DRWUKAS/Precision-Tweezer-Grinder/README.md

# Precision Tweezers Grinder — Hack Club Stasis

An enclosure and hardware design for a precision tweezers grinder built during the Hack Club Stasis hackathon. This device provides a stable, motorized solution for sharpening and maintaining precision tools.

🌐 **OnShape CAD Workspace:** https://cad.onshape.com/documents/27c54b4b3d9ffb5c67df1a65/w/bfb7f68973eb2576e4aceb32/e/55b7abdc1bfcae4972785b61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

---

## 🛠️ Hardware & Components
* **Motor:** 5V DC Motor
* **Switch:** SPDT Toggle Switch
* **Power Input:** Direct USB Cable (modified 5V input)
* **Fasteners:** M3 Screws (tapped holes)

## 📑 Engineering Build Logs & Journal

### 🛠️ Log 1: Sketching and Main Measurements/Design
* **Focus:** Initial Component Gathering & Concept Layout
* Gathered all core project components: a 5V DC motor, SPDT switch, and USB power components.
* Sketched out all physical dimensions of the components by hand to translate the physical sizes into clean CAD parameters within OnShape.
 


### 💻 Log 2: Day 1 CAD Base
* **Focus:** Main Body Enclosure and Press-Fits
* Designed the primary motor and switch models in OnShape to visualize the spacing constraints.
* Built out the main body chassis and recessed a fitted compartment for the motor core.
* Designed mounting tabs for the top and bottom chassis split using $2.4\text{ mm}$ diameter guide holes optimized for custom tapping to M3 threads.
* Integrated a precise, low-clearance press-fit slot to securely friction-mount the SPDT switch into the outer shell wall.





### 🖨️ Log 3: First Print & CAD Refinements
* **Focus:** Proof of Concept & Tolerance Adjustment
* **Time Tracked:** 2 hours (1 hr 15 mins CAD / 45 mins assembly and tinkering)
* Manufactured the initial 3-part prototype assembly via a 3D printer.
* **Discovered Design Issues:**
  * The vertical alignment column on the base plate sat too close to the main structural wall, preventing clean fabrication with a standard $0.4\text{ mm}$ extrusion nozzle.
  * The raw Micro-USB cutout area required removal in favor of a specialized alignment pad on the lower chassis plate to simplify printing and increase wall stiffness.
  * The internal motor seating pocket wall required wider clearance for a smooth drop-in fit.
    
    
    

### 🔧 Log 4: Final Adjustments & Part Fitment
* **Focus:** Hardware Integration & Mechanical Finish
* **Time Tracked:** 45 minutes (0.75 hours)
* Modified hole dimensions and re-worked the Micro-USB retention bracket constraints to lock it permanently in place against internal sliding forces.
* Fabricated the updated component set. All adjusted clearances matched physical parts perfectly.
* Tapped the main case guide holes for M3 hardware, routed all internal components, and securely bolted the entire enclosure shell together.
  
  
  

### ⚡ Log 5: Soldering & Final Assembly
* **Focus:** Wiring and Integration Challenges
* **Time Tracked:** 2 hours 20 minutes (2.33 hours)
* Hit unexpected integration friction while working with the standalone Micro-USB interface port. Soldering raw wires directly onto mini interface pins without creating solder bridges or wire detachment issues proved incredibly difficult.
* **Engineering Pivot:** Bypassed the unstable breakout interface port by stripping a standard USB power cable down to raw copper leads, routing it directly into the chassis, and soldering it inline.
* **Result:** Successfully closed the loop! The circuit operates reliably under full load. Future revisions will transition to a dedicated USB power breakout board for a cleaner commercial finish.
  
  

  #Video Of Working Project
  https://www.youtube.com/shorts/dYoDzPScT6I

  ## 📂 Project Repository Files

<details>
<summary>📦 <b>Click to expand individual CAD & 3D Print Files</b></summary>

### 🛠️ Master CAD Source Files (.step)
* 💾 [Assembly 1.step](./Assembly%201.step)
* 💾 [Bottom Half.step](./Bottom%20Half.step)
* 💾 [Motor.step](./Motor.step)
* 💾 [Precision tweezers Main Body.step](./Precision%20tweezers%20Main%20Body.step)
* 💾 [Switch.step](./Switch.step)
* 💾 [Top Spinner.step](./Top%20Spinner.step)
* 💾 [USB.step](./USB.step)

### 🖨️ 3D Printable Mesh Files (.stl)
* 🧩 [Assembly 1.stl](./Assembly%201.stl)
* 🧩 [Bottom Half (3).stl](./Bottom%20Half%20(3).stl)
* 🧩 [Motor.stl](./Motor.stl)
* 🧩 [Precision tweezers Main Body (2).stl](./Precision%20tweezers%20Main%20Body%20(2).stl)
* 🧩 [Switch.stl](./Switch.stl)
* 🧩 [Top Spinner (2).stl](./Top%20Spinner%20(2).stl)
* 🧩 [USB.stl](./USB.stl)
