DRWUKAS/Precision-Tweezer-Grinder/BOM.csv

BOM.csv
Item | Quantity | Description
5V DC Motor | 1 | Prime motor for the grinding mechanism
SPDT Rocker Switch | 1 | Power actuation toggle
USB Power Cable | 1 | Stripped copper wire connection for 5V input
M3 Machine Screws | 4 | Fasteners for holding chassis shell halves together
3D Printed PLA Enclosure | 1 | Custom chassis parts designed in Onshape
