DRWUKAS/Precision-Tweezer-Grinder/Assembly 1.step

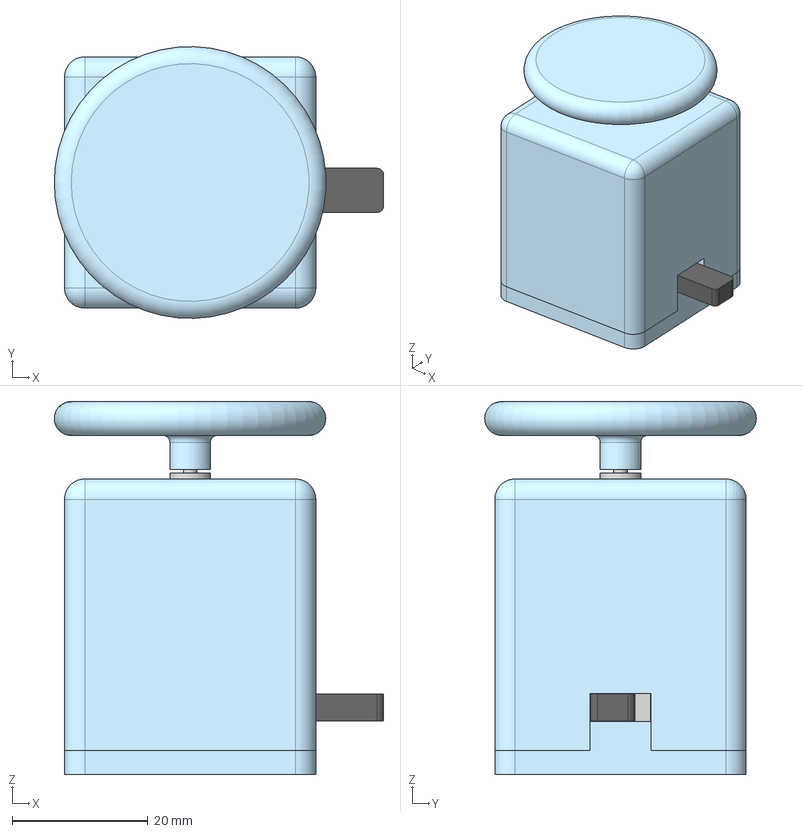
[picture p1: CAD file, 2026-06-20]
Assembly 1.step
48.5 x 40.0 x 54.9 mm
