DRWUKAS/Precision-Tweezer-Grinder/Precision tweezers Main Body.step

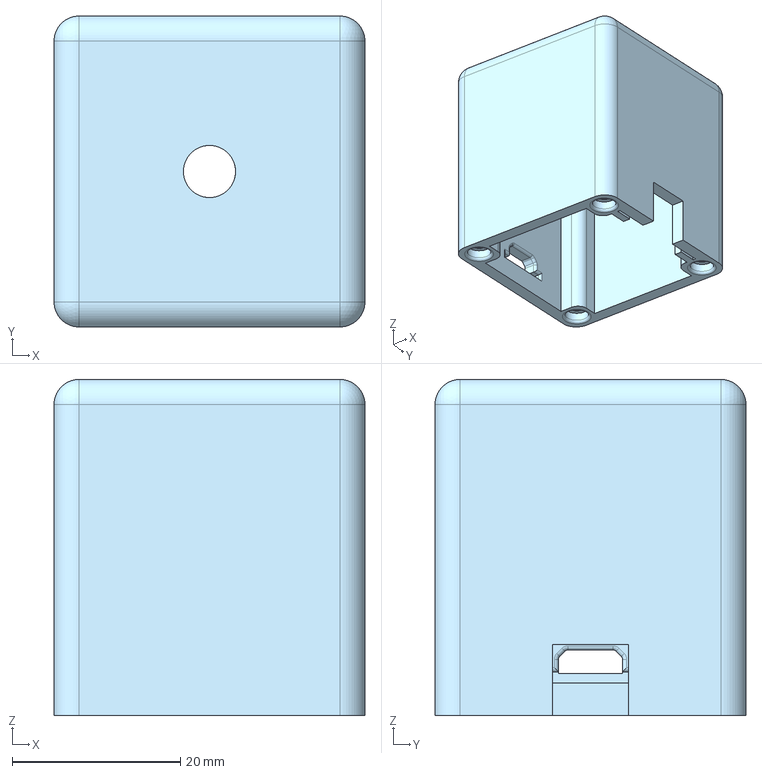
[picture p2: CAD file, 2026-06-20]
Precision tweezers Main Body.step
37.0 x 37.0 x 40.0 mm
