DRWUKAS/Precision-Tweezer-Grinder/Top Spinner.step

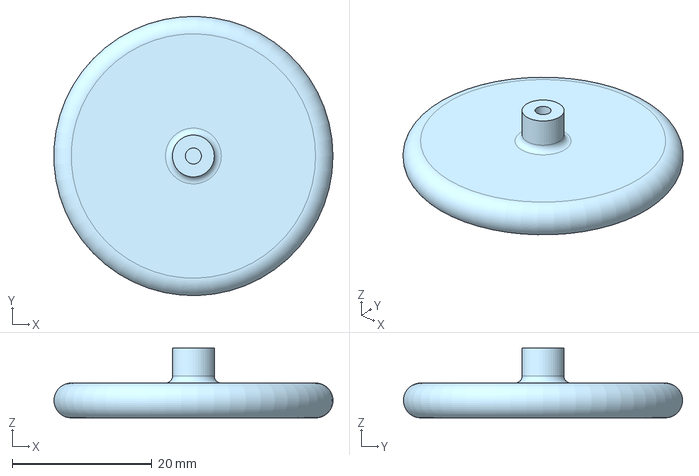
[picture p3: CAD file, 2026-06-20]
Top Spinner.step
40.0 x 40.0 x 10.0 mm
