DRWUKAS/Precision-Tweezer-Grinder/USB.step

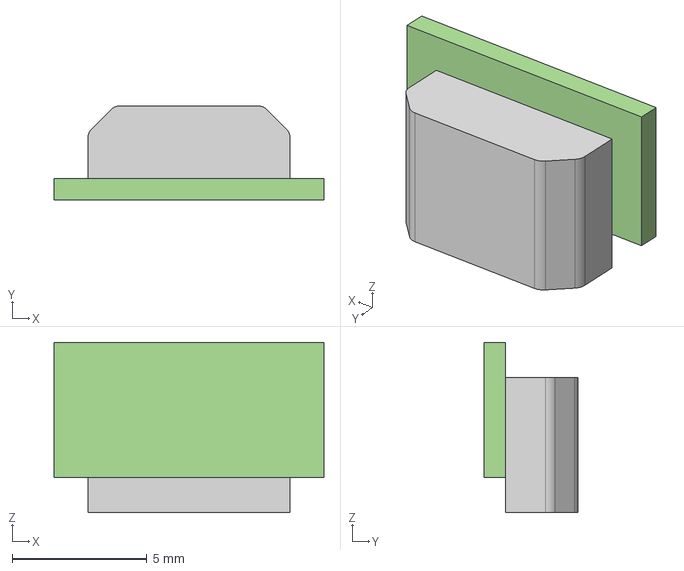
[picture p4: CAD file, 2026-06-20]
USB.step
10.0 x 3.50 x 6.30 mm
