DRWUKAS/Precision-Tweezer-Grinder/Switch.step

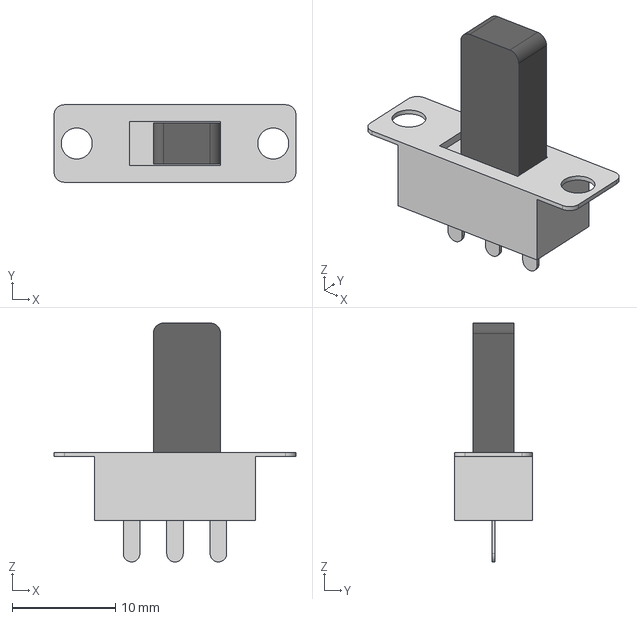
[picture p5: CAD file, 2026-06-20]
Switch.step
23.4 x 7.50 x 23.1 mm
