DRWUKAS/Precision-Tweezer-Grinder/Motor.step

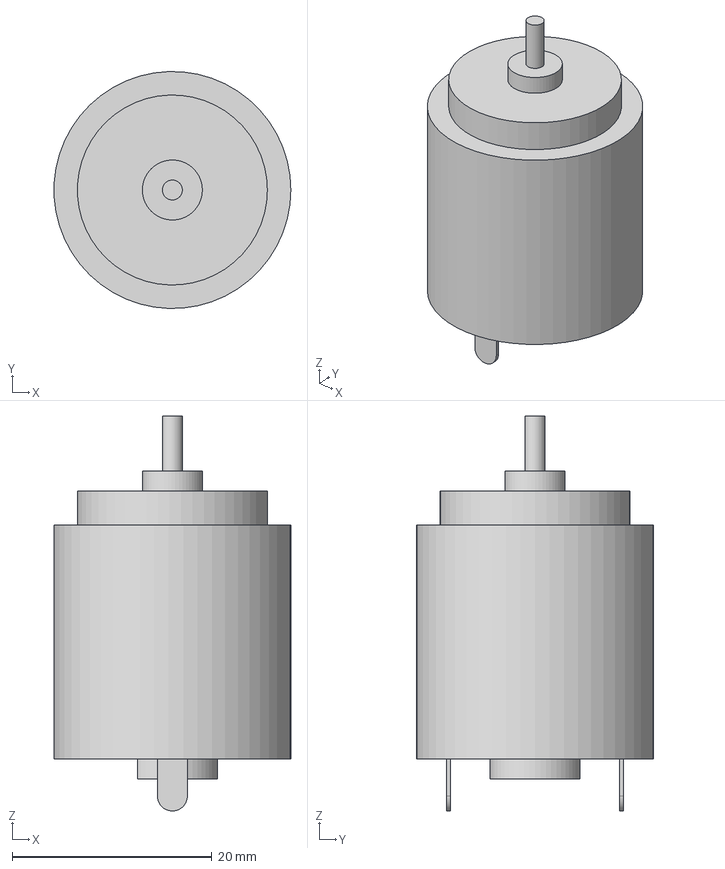
[picture p6: CAD file, 2026-06-20]
Motor.step
23.7 x 23.7 x 39.5 mm
