DRWUKAS/Precision-Tweezer-Grinder/Bottom Half.step

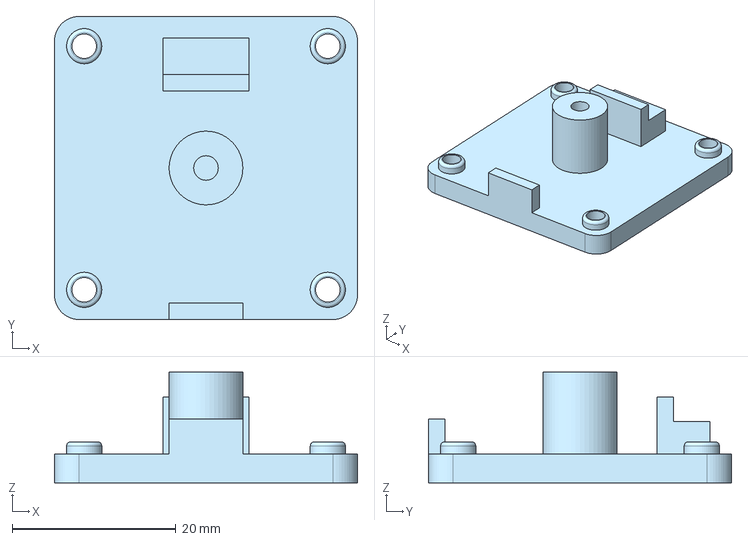
[picture p7: CAD file, 2026-06-20]
Bottom Half.step
37.0 x 37.0 x 13.5 mm
