DRWUKAS/Precision-Tweezer-Grinder/(list of files, cad)

Other CAD files:
Precision tweezers Main Body (2).stl
Top Spinner (2).stl
Bottom Half (3).stl
Motor.stl
Switch.stl
USB.stl
